Vineet-Menon/Pan_Tilt_mechanism/Components/Nema 17 stepper motor/Motor image_1.jpeg

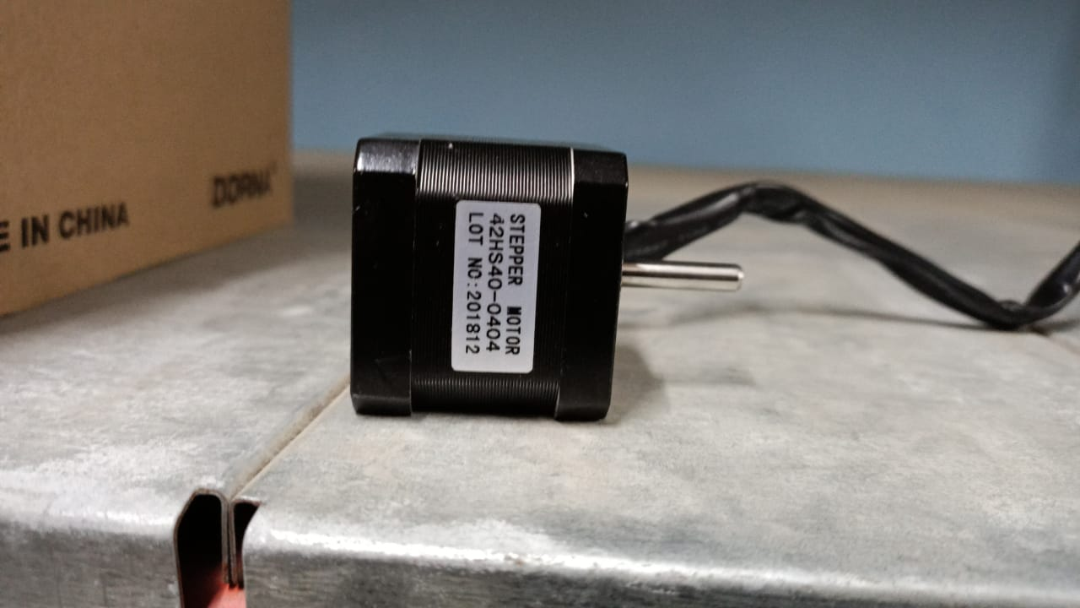
Components/Nema 17 stepper motor/Motor image_1.jpeg
