Vineet-Menon/Pan_Tilt_mechanism/Components/Nema 17 stepper motor/42HS40-0404 speed_torque graph.jpeg

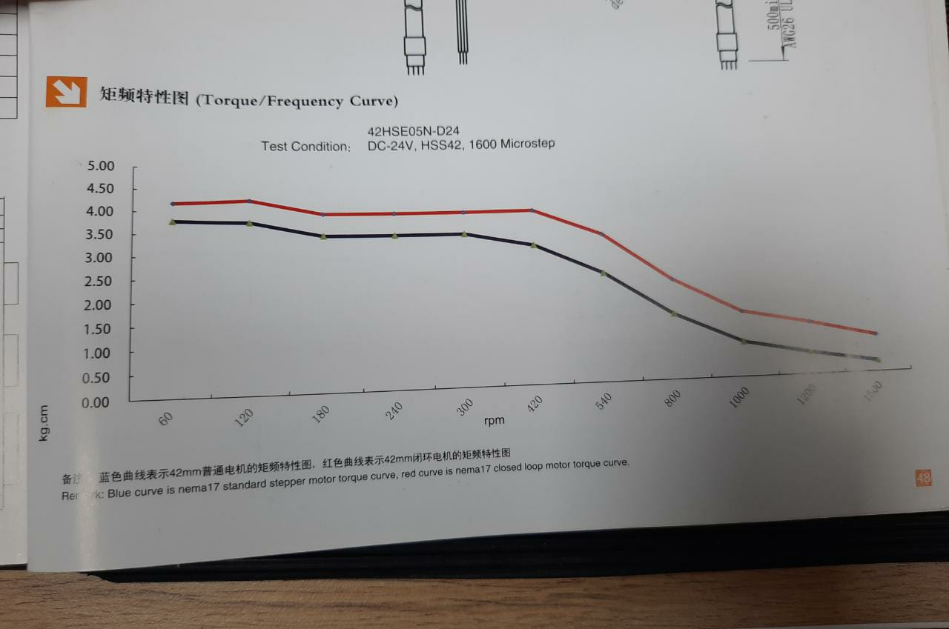
Components/Nema 17 stepper motor/42HS40-0404 speed_torque graph.jpeg
