Vineet-Menon/Pan_Tilt_mechanism/README.md

# Pan_Tilt_mechanism
 Camera pan and tilt mechanism with closed-loop feedback control for terrain mapping applications
