Vineet-Menon/Pan_Tilt_mechanism/Reference_links.txt

https://electronics.stackexchange.com/questions/236572/count-pwm-pulses-fed-into-stepper-motor-fet-driver - isolating timing generation for stepper control
https://playground.arduino.cc/Main/TimerPWMCheatsheet/ - variable frequency pwm generation

https://www.arduino.cc/en/reference/SPI - SPI documentation

https://github.com/GadgetReboot/Arduino/tree/master/Uno/X9C_Button_Test - programmable POT

https://www.youtube.com/watch?v=bDjuvhEt0og - control stepper speed with timer IC
