Vineet-Menon/Pan_Tilt_mechanism/Overfeaf reports/Pan_Tilt_Design_report.pdf

## Pan Tilt Design report

Vineet Menon, Rishabh Singh, Mangal Kothari

Abstract

The aim of this project is to develop a 2 degree of freedom purely rotational pan-tilt mechanism which can provide stable rotation about the Yaw(for Pan) and Pitch(for Tilt) axes. This mechanism can be used for application such as terrain mapping (using a limited FOV stereo/ RGB-D camera), object tracking and as a gimbal (for stable camera feed).

## 1 Introduction

In this design report, the following parts are going to be covered in detail:

1. Design and fabrication
2. Component description and BOM
3. Mathematical model of system (state variable matrix, transformation matrix)
4. HSM control equations with driver
5. System architecture

[note: literature survey left to be added ] citations: [3]; [4]; [7]; [2]; [5]; [8]

## 2 Design and Fabrication

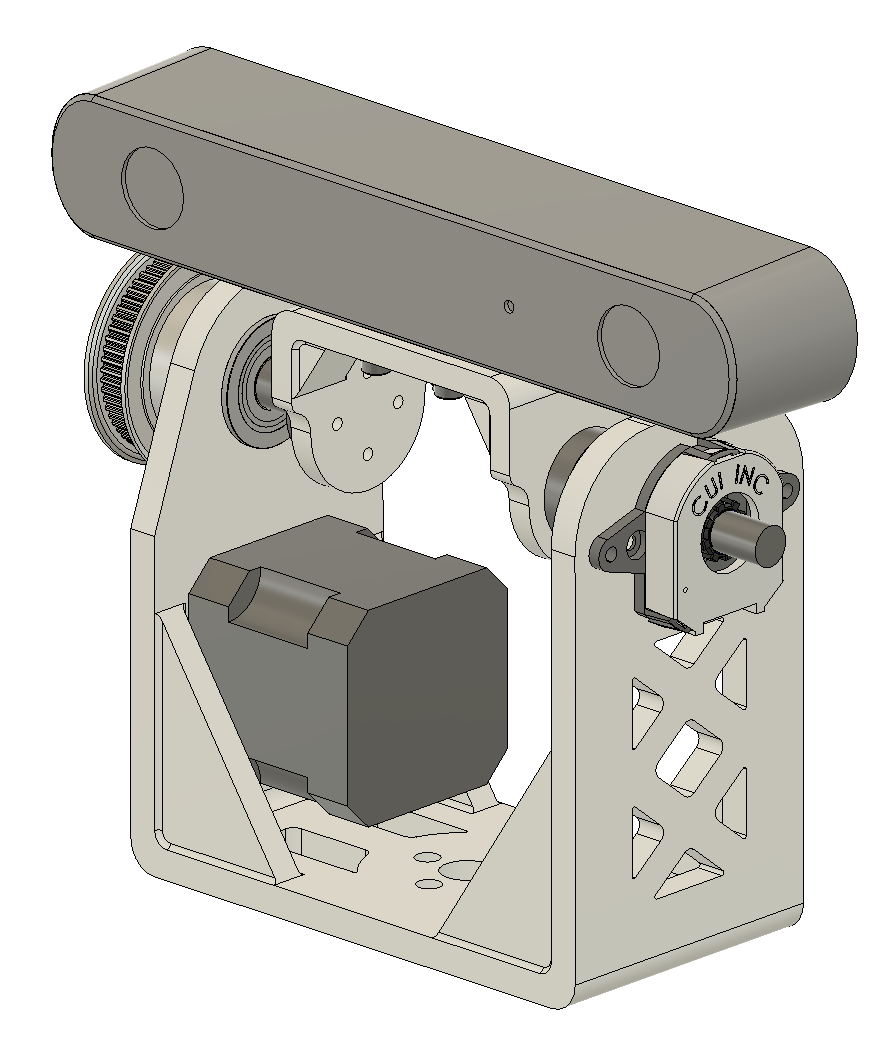
[picture p3: figure]

Figure 1: 3D model of the Tilt platform

## 3 Components used in the Tilt mechanism-

### 3.1 Stepper motor:

A stepper motor is a brushless, synchronous electric motor that converts digital pulses into mechanical shaft rotation [12]. Every revolution of the stepper motor is divided into a discrete number of steps, in many cases 200 steps, and the motor must be sent a separate pulse for each step. The stepper motor can only take one step at a time and each step is the same size.
The properties of the motor which we are using are as follows:
- Step angle = 1.8 degree/pulse or 200 pulse/revolution
- Rated voltage = 12V
- Rated current = 0.4A
- Phase resistance = 30Ω
- Phase Inductance = 60mH
- Holding torque = 4.2kg-cm
- Detent torque = 220g.cm
- Rotor inertia = 54g.cm²
- Weight = 0.28kg

### 3.2 CUI AMT22 MODULAR ABSOLUTE ENCODER:

Absolute encoders provide angular position of the load to which it is connected via a shaft. The resolution of this encoder depends on the number of digital bits the encoder is capable of producing which has to be read by a MCU. Thus this device can be used as a feedback unit in applications like robotics, precision automation and assembly applications that require absolute position. The following are the feature of the AMT22 series encoder :

- Full duplex Serial Peripheral Interface (SPI)
- 12-bit absolute position
- Checksum bits for error detection
- Digitally settable zero position

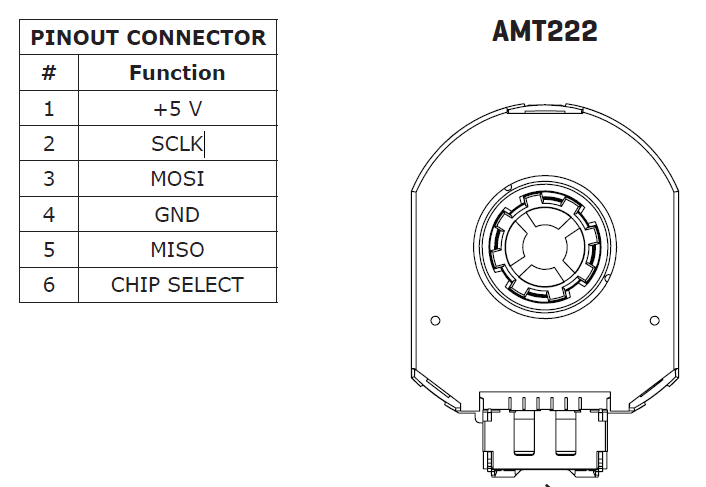
[picture p4: figure]

Figure 2: Pin-out of the absolute encoder

### 3.3 IMU (accelerometer and gyroscope)-

The Bosch BNO055 smart sensor is a System in Package (SiP) solution which has an MEMS accelerometer, magnetometer and gyroscope. By integrating them with a high speed ARM Cortex-M0 based processor [9], the sensor fusion of the 9 DOF IMU is done on the SoC itself. Thus, we can directly access quaternions, Euler angles or vectors through I²C communication.

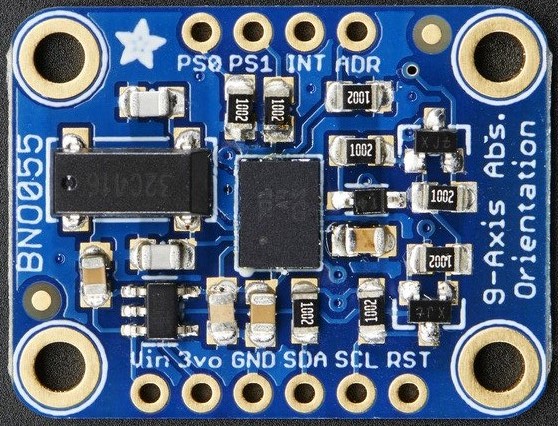
[picture p5: figure]

Figure 3: BNO055 9-Dof IMU

### 3.4 Stepper motor driver-

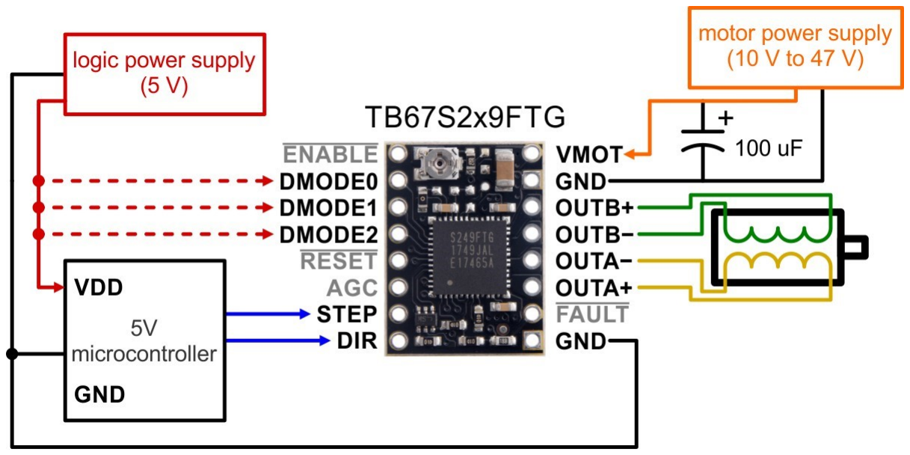
[picture p6: figure]

Figure 4: 16 pin TB67S249FTG driver

This is a breakout board for Toshiba’s TB67S249FTG family of stepper motor drivers, which allows us to control one bipolar stepper motor using a MCU. The following are the salient features of the motor driver-

- Motor supply voltage: 10 V to 47 V
- Maximum continuous current per phase without additional cooling: 1.6 A (4.5 A peak)
- Simple step and direction control interface
- Several different step modes: full-step, circular half-step, 1/4-step, 1/8-step, 1/16-step, and 1/32-step
- Adjustable current control lets us set the maximum current output with a potentiometer according to the motor’s current rating
- Inbuilt Active Gain Control (AGC) automatically sets the required drive current based on the torque requirement of the motor at every instance.

### 3.5 Timing Pulley and Belt

- Driver pulley properties-

– No. of teeth: 15

– Pitch diameter: 9.70mm

- Driven pulley properties-

– No. of teeth: 60

– Pitch diameter: 38.81mm

- Timing belt properties-

– No of grooves: 90

– Centre-to-centre distance: 51.4 mm

### 3.6 Flanged ball bearings -

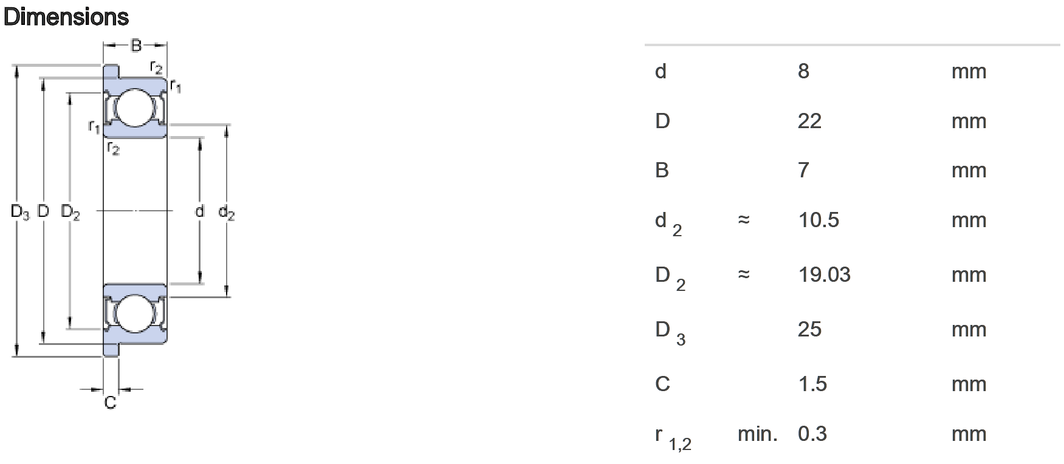
[picture p7: figure]

## 4 Mathematical model of system

The nonlinear model based on the Lagrange-Euler equation is as follows.

µ = M(θ)

¨θ + C(θ, ˙θ)

˙θ + F(

˙θ) + g(α)

Here µ = τ is control input and θ is feedback input vector representing the joint orientation, M(θ) is an inertia matrix and C(θ, ˙θ) accounts for centrifugal and coriolis forces. The term F(

˙θ) accounts for the viscous friction. The term g(α) accounts for gravity forces, here α is angle between the arm length and force (mg). The term C(θ, ˙θ) is effective when the mass centre begins to move away from the centre of rotation. The effect of centrifugal force becomes evident on the distributed mass of the body. Therefore, centre of PTP is located on the rotational axis of the body and term C(θ, ˙θ) is neglected in linear model. Thus the reduced non-linear-system equation for single mechanism (joint) is given as:

τ = Jef f ¨θ + fef f ˙θ + mglsinθ

Here, τ = Torque, Jef f = Effective Inertia Load, fef f = viscous friction coefficient
This is a general equation for both the joints and represents the non-linear model of pan and tilt mechanism. The viscous friction is a frictional force that resists objects in motion. The viscous friction is actually a property of the medium in which the motion of the object is occurring. Any fluid medium, such as the grease in the bearings or the air, has an internal resistance to flow, which is represented by the viscous friction. The effective inertial loads and viscous friction coefficient of the system are computed using following relation [1]:

Jef f = Jm + n

2Jl
, fef f = fm + n

2
fl

Here, Jm = Motor Inertia, Jl = Load Inertia, n = Gear ratio between motor and load

## 5 Hybrid Stepper Motor Control equations -

Stepper motors are controlled using off-the shelf driver modules which acquires a square pulse as input from a microcontroller or a timer circuit and based on time period of the single pulse, the motor rotates by a certain step (1.8 degree) or microstep (factors of 1.8). A trail of pulse is required to rotate the motor to a desired angle.

α = F[M, T out]

Where,
α = required step/micro-step angle
M= desired microstepping factor
Tout = Time period of the input square pulse

### 5.1 Micro-stepping angle-

The default step angle of our stepper motor is 1.8 degrees per pulse. This indicates that when microstepping factor(M) is unity, the shaft of the motor will rotate by 1.8 degree when a square pulse is applied at the ’STEP’ pin of the driver.
In certain drivers, there is an feature called ”Micro-stepping” using which we can reduce this step angle to finer values like 0.9 degrees, 0.45 degrees and so on. The general equation for micro-stepping can be written as -

α = 1.8/M

This equation will yield the microstep angle α in degrees. To maintain our calculations in S.I. units, we convert this value to radians using the following conversion -

α = (1.8/M) ∗ (π/180)

α = π/(100M)

A point to be noted here is that since we are using a pulley-belt reduction mechanism, our load(camera) will be rotating 4 times slower than the motor. This means that if the motor’s step angle changes by α, the load’s angle would change by α

0
and α

0
can be denoted as -

α

0
= π/(400M) | (1)

### 5.2 Angular Speed of the motor -

For simplicity, we will enter the maximum desired angular rotation ω of the load in terms of rpm (revolutions per minute). But in order to keep all calculations in S.I. unit, we calculate ω

0
which represents angular rotation in rad/sec -

ω

0
= [(2π)/60] ∗ ω | (2)

### 5.3 Frequency of the square pulse to be generated -

Since we now have the values for α

0
and ω

0
, we now calculate the Frequency (Fout) and Time period (Tout) of the square pulse needed to be generated.

ω

0
= α

0
/T out

ω

0
= α

0
∗ F out

F out = ω

0

/α⁰

F out = [(2π/60) ∗ ω] ∗ [(400M)/π]

F out = (40/3) ∗ Mω | (3)

### 5.4 Determine the number of pulses -

Now with the calculated value of Fout or Tout, we know that on applying one such pulse the motor will rotate by a step or micro-step. But if we want the motor to rotate to a certain angle say θf inal, we need to send a trail of square pulses which would continuously rotate the shaft of the motor in discrete micro-steps at a speed depending on the value of Tout.
To determine this value of pulse count (plscount), we make a simple comparison as follows -If one pulse of frequency Fout corresponds to α

0
where α

0
= π/(400M);
’plscount’ number of pulses of frequency Fout should correspond to θf inal On comparison we get,

plscount ∗ α

0
= θf inal

plscount =

(4M) ∗ θf inal
1.8

plscount =

20 ∗ Mθf inal
9

(4)

## 6 System Implementation-

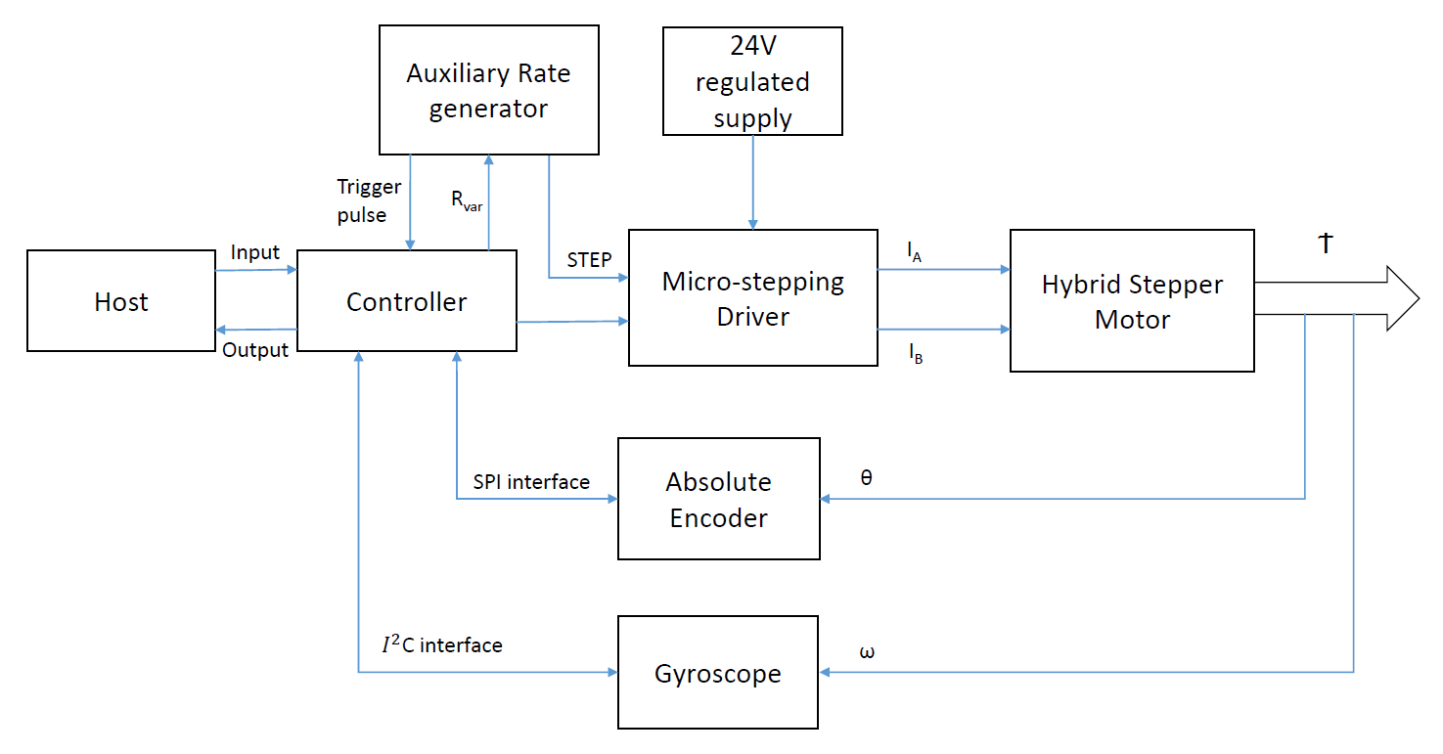
[picture p8: figure]

The goal of our system is to ensure that the load is rotated to the required angle while never exceeding the specified rotation speed limit (in rpm). Both the threshold angles and maximum speed are specified by the user. The following are the electronic components use to implement and ensure that the stepper motor is properly controlled as per the angular velocity and angle commanded by the PID controller.

- Host-

– Function: To acquire input parameters from the user (w(max), M, endpoint angles [Theta(max), Theta(min)]), calculate the values of Fout and plscount and pass on the calculated values to the controller.

- Controller-

– Function: The controller acts as a bridge between the host and the subordinate components like feedback sensors, stepper motor controller and auxiliary rate generator circuit. We will be using Atmega 2560 Pro for basic prototyping, but eventually replace it with a STM32F4 development board.

- Sensors-

– Absolute encoder: Connected to the output shaft of the load. The output is read by the micro-controller in the form of a 12-bit binary value which represents the absolute angular position of the load driven by the effect of the driven pulley. This is indeed the source of angular position feedback.

– Gyroscope: Interfaced directly with the frame connected to the load. This will provide angular velocity (in rad/sec) with respect to the Y-axis of the IMU (pitch axis). This is indeed the source of angular velocity feedback.

- Auxiliary rate generator-

– Function: The rate generator circuit will be designed such that depending on the required value of pulse frequency (Fout), a square pulse would be generated by the timer circuit which is then feed to the ”STEP” pin of the stepper motor driver.

### 6.1 Micro-controller interfacing with Absolute encoder-

The transmission of data from absolute encoder is accomplished in the form of a synchronous serial data protocol known as SPI(Serial Peripheral Interface) as described in [14]. The connections from the encoder to the Arduino based micro-controller are made with reference to guidelines provided in [10]. It is as shown in the figure below-

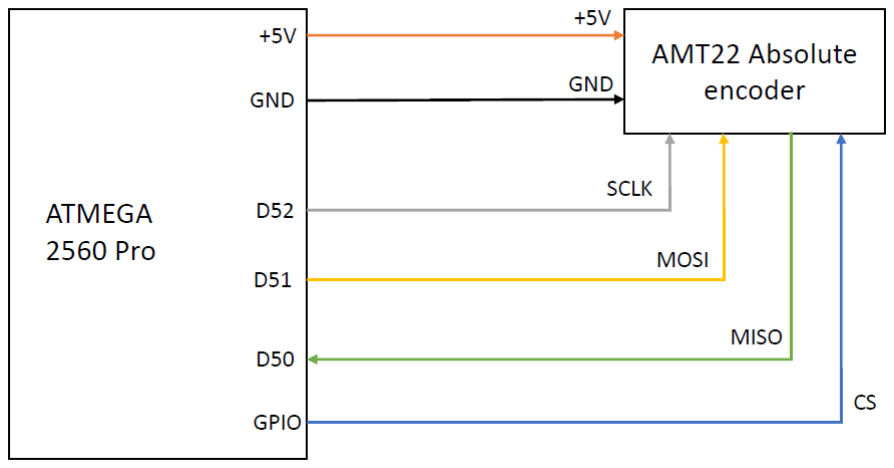
[picture p9: figure]

The absolute encoder datasheet and the sample reference program provided by CUI [11] were thoroughly considered to properly interface the encoder with the micro-controller.

### 6.2 Micro-controller interfacing with Stepper motor and driver-

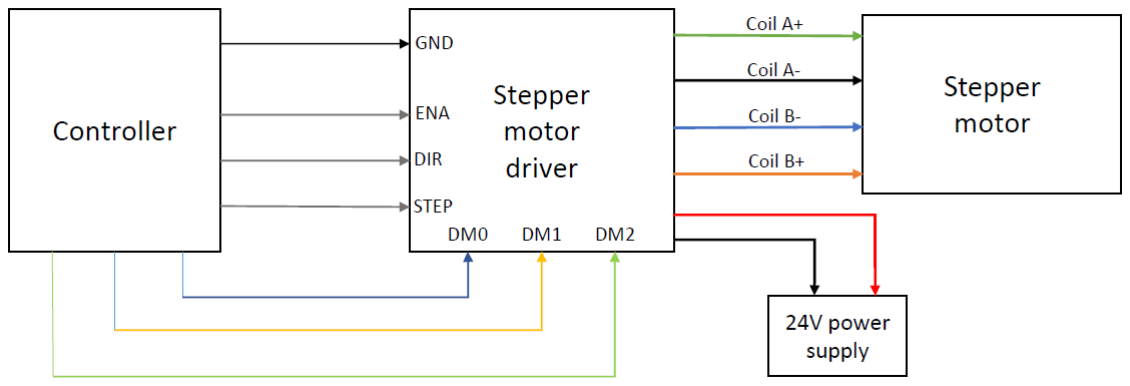
[picture p10: figure]

The stepper motor driver which we are using is a Toshiba TB67S249FTG based compact carrier board. This carrier board enables us to regulate the speed and alter the direction of the stepper motor through command signals provided by the micro-controller to the ”STEP” and ”DIR” pins of the driver respectively. The program logic for the same was executed on the same Atmega 2560 controller which is used to read the encoder data. The guidelines provided by the manufacturer [13] were referred thoroughly while writing the embedded program for the control of the stepper program.

### 6.3 Timer generation function -

In [6], a PD frequency control is adopted as means to set the desired speed of stepper motor by adjusting the output pulse frequency of STM32 MCU. By setting the correct prescaler value (TIM Prescaler) and count cycle (TIM Period) of the STM32 timer, a square pulse of desired frequency can be generated. The Hardware Abstraction Layer(HAL) feature present in the Keil ARM-MDK software [15] will be utilised for this task.

## References

[1] Madan Gopal. Control systems: principles and design. Tata McGraw-Hill Education, 2002.
[2] Ole C. Jakobsen and Eric N. Johnson. “Control Architecture for a UAV-Mounted Pan/Tilt/Roll Camera Gimbal”. In: InfoTech @Aerospace by American Institute of Aeronautics and Astronautics. Arlington, Virginia, 2005, pp. 1–10.
[3] I. S. Sarwar and A. M. Malik. “Stability analysis and simulation of a two DOF robotic system based on linear control system”. In: 15th International Conference on Mechatronics and Machine Vision in Practice. Auckland, New Zealand, 2008, pp. 263–268.
[4] I.S. Sarwar, J. Iqbal, and A.M Malik. “Modeling, analysis and motion control of a pan tilt platform based on linear and nonlinear systems”. In: WSEAS Transactions on Systems and Control 4.8 (Aug. 2009), pp. 389–398.
[5] R. Antonello et al. “IMU-based image stabilization in a HSM-driven camera positioning unit”. In: 2013 IEEE International Conference on Mechatronics (ICM). Vicenza, 2013, pp. 156–161.
[6] R. Zhang et al. “Control system design for two-wheel self-balanced robot based on the stepper motor”. In: Proceedings of 2013 IEEE International Conference on Service Operations and Logistics, and Informatics. Dongguan, China, 2013, pp. 241–244. doi: 10.1109/ SOLI.2013.6611417.
[7] R. J. Rajesh and P. Kavitha. “Camera gimbal stabilization using conventional PID controller and evolutionary algorithms”. In: 2015 International Conference on Computer, Communication and Control (IC4). Indore, India, 2015, pp. 1–6.
[8] Xiangyang Zhou et al. “Structural multi-objective optimization on a MUAV-based pan–tilt for aerial remote sensing applications”. In: ISA Transactions (Nov. 2019).
[9] Adafruit. BNO055 9 DOF IMU. url: https://learn.adafruit.com/adafruit-bno055-absolute-orientation-sensor. (accessed: 13.03.2020).
[10] Arduino. SPI library. url: https://www.arduino.cc/en/reference/SPI. (accessed: 08.03.2020).
[11] CUI Devices. Absolute Encoder. url: https://www.cuidevices.com/product/motion/rotary-encoders/absolute/modular/amt22-series. (accessed: 08.03.2020).
[12] OMEGA. Stepper Motors. url: https://in.omega.com/prodinfo/stepper_motors. html. (accessed: 12.03.2020).
[13] Pololu. TB67S249FTG Stepper Motor Driver. url: https://www.pololu.com/product/3096. (accessed: 08.03.2020).
[14] Sparkfun. Serial Peripheral Interface (SPI). url: https : / / learn . sparkfun . com / tutorials/serial-peripheral-interface-spi/all. (accessed: 08.03.2020).
[15] Sysprogs. Controlling STM32 Hardware Timers using HAL. url: https://visualgdb.com/tutorials/arm/stm32/timers/hal/. (accessed: 11.03.2020).
