Vineet-Menon/Pan_Tilt_mechanism/Components/ATmega_2560_pro_pinout.jpg

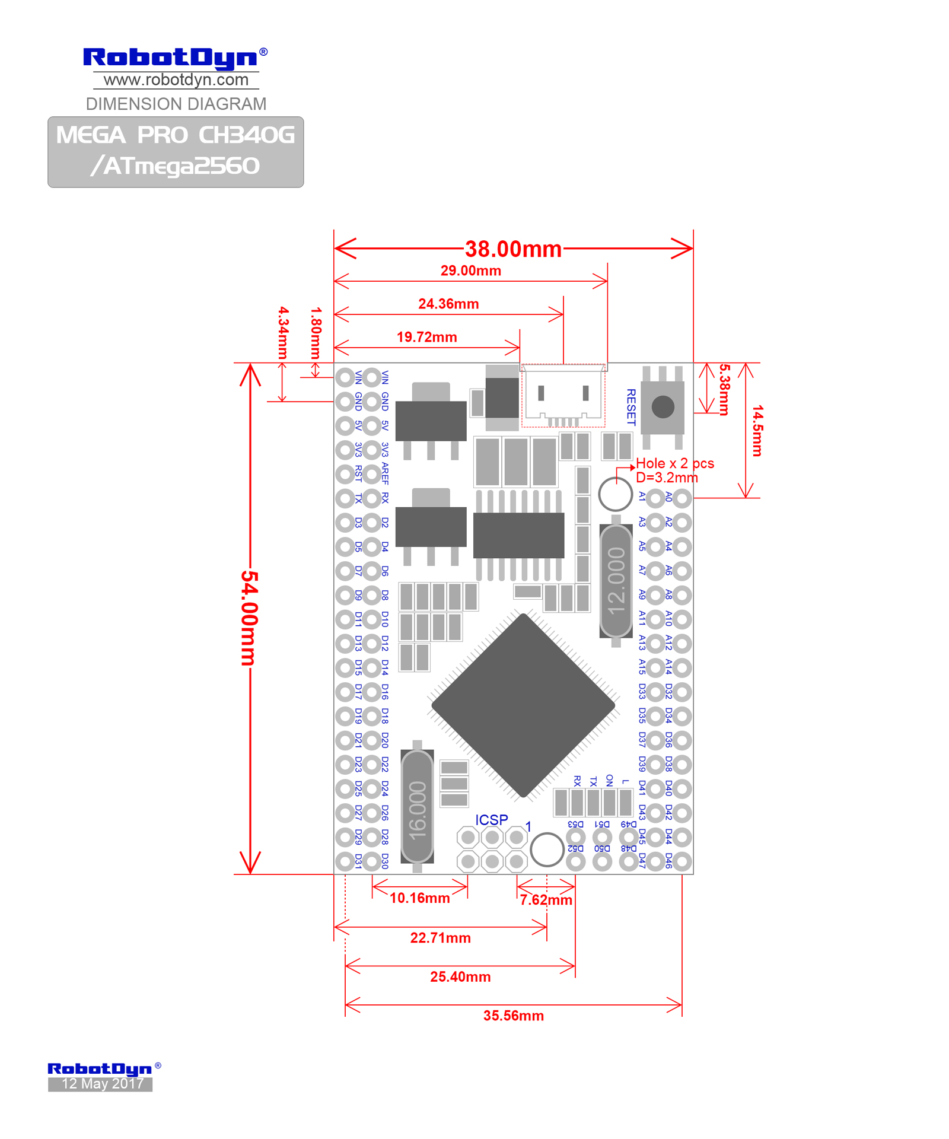
Components/ATmega_2560_pro_pinout.jpg
