Vineet-Menon/Pan_Tilt_mechanism/Components/CUI_AMT22/Abs_Enc_links.docx

https://www.cuidevices.com/product/motion/rotary-encoders/absolute/modular/amt22-series - Information link

https://www.cuidevices.com/product/motion/rotary-encoders/absolute/modular/amt22-v-kit - Kit link

https://www.digikey.com/product-detail/en/cui-devices/AMT222A-V/102-5921-ND/9838234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 – Purchase link
