Vineet-Menon/Pan_Tilt_mechanism/Components/Stepper driver/pin_connections.pdf

Pin_name | Pin_number on Arduino
Dmode0 | 11
Dmode1 | 10
Dmode2 | 9
Dir | 12
Step | 7
