Vineet-Menon/Pan_Tilt_mechanism/Components/Stepper driver/web_link.txt

https://www.pololu.com/product/2973/resources
