Vineet-Menon/Pan_Tilt_mechanism/Components/Nema 17 stepper motor/Luna_42HS.png

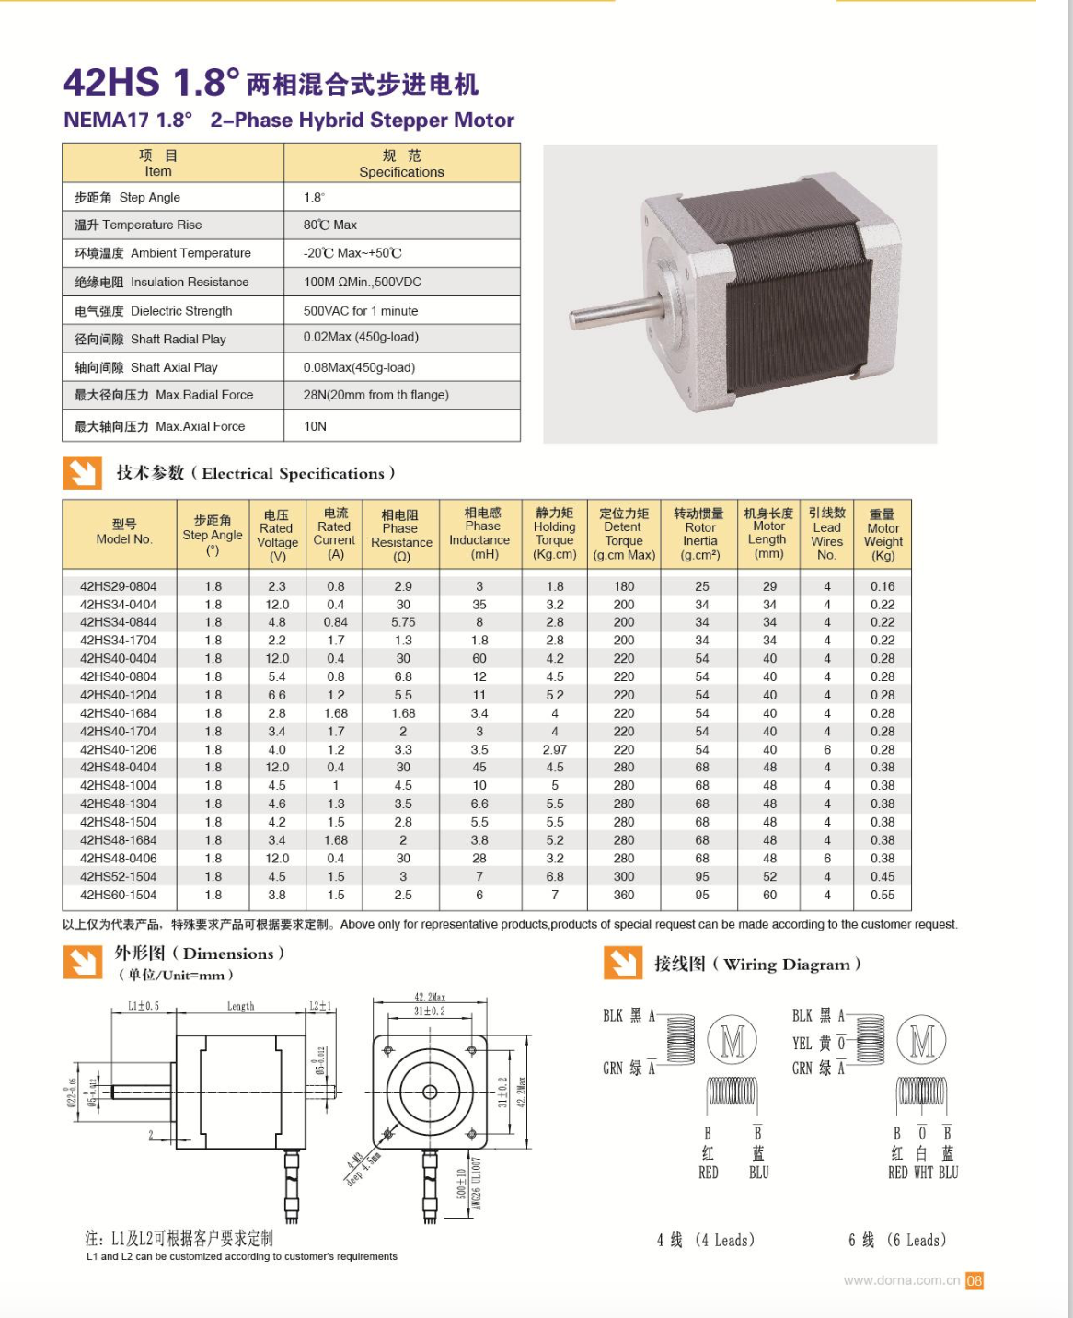
Components/Nema 17 stepper motor/Luna_42HS.png
