Vineet-Menon/Pan_Tilt_mechanism/Components/Stepper driver/Connections.jpg

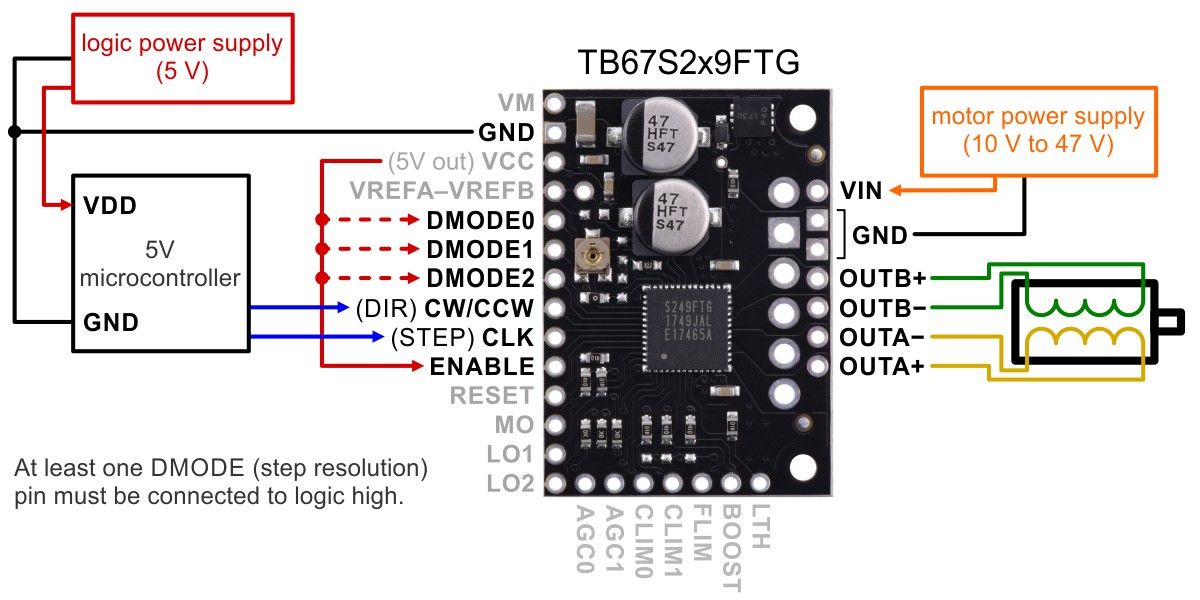
Components/Stepper driver/Connections.jpg
