Vineet-Menon/Pan_Tilt_mechanism/Components/Stepper driver/Microstepping.PNG

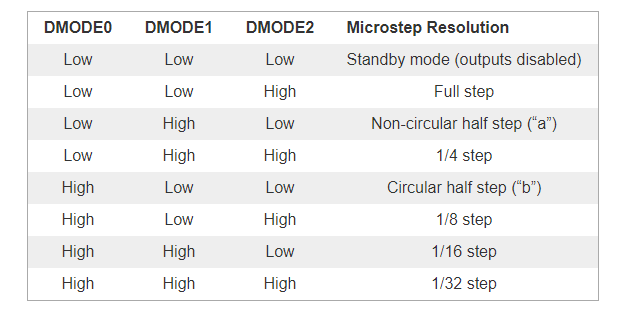
Components/Stepper driver/Microstepping.PNG
