Vineet-Menon/Pan_Tilt_mechanism/Designs/ZED.step

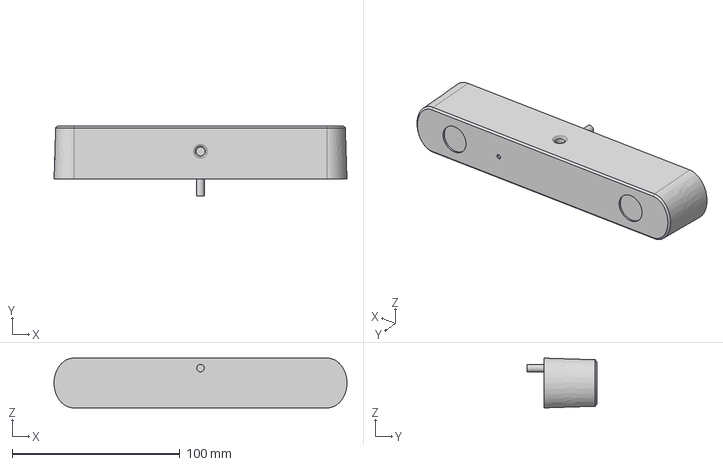
[picture p16: CAD file, 2020-02-02]
Designs/ZED.step
174.7 x 41.6 x 29.7 mm
