Vineet-Menon/Pan_Tilt_mechanism/Designs/W 608 R-2Z.stp

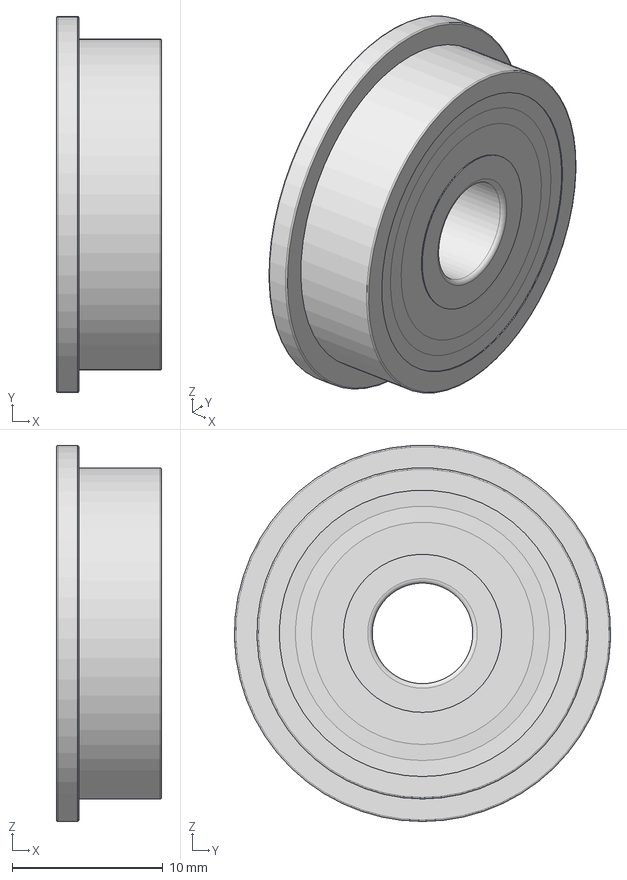
[picture p17: CAD file, 2020-02-02]
Designs/W 608 R-2Z.stp
7.00 x 25.0 x 25.0 mm
_W 608 R-2Z_PART1
_W 608 R-2Z_PART2
_W 608 R-2Z_PART3 x 7
_W 608 R-2Z_PART4 x 7
