Vineet-Menon/Pan_Tilt_mechanism/(commit log)

2020-02-02 Designs updated
    [W 608 R-2Z.stp, ZED.step]
2020-02-03 Updates
    Absolute encoder design changed
    Tilt design
    Motor driver information
2020-02-06 Stepper code changed
2020-02-07 Stepper code update
2020-02-07 Update TB67S249FTG_quater_step.ino
    Use Enable pin only when needed to avoid noise
2020-02-11 half microstepping update
    working well for 3 rpm
2020-02-11 Update TB67S249FTG_half_step.ino
    working well for 6 rpm
2020-02-15 variable frequency pwm test
    Using pwm library
2020-02-16 PWM library added
    PWM test successful
2020-02-16 Stepper control with variable frequency PWM
2020-02-17 Code changed
    RPM is fine, but position error
    [Stepper_pwm.ino]
2020-02-19 general microstep code
    tested for 2x and 4x microstepping
    works well for speed uptil 6 rpm
2020-02-20 Encoder SPI communication test
    Successful!
2020-02-20 encoder code update
    delay changed and separate program for setting home position
2020-02-22 SPI on mega
2020-02-22 Closed loop stepper control with encoder
    Testing...
2020-02-23 encoder reading with stepper
2020-02-23 Angle conversion equated
    Speed variation achieved from 0-48 rpm
